JhonVelasquez/Car_Speed_Control_2_wheels/Generation_path/pngwing.com.png

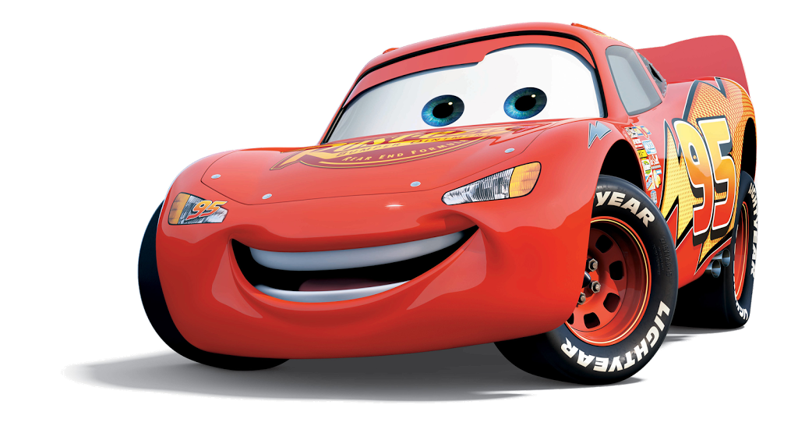
Generation_path/pngwing.com.png
