JhonVelasquez/Car_Speed_Control_2_wheels/README.md

# Car_Speed_Control_2_wheels

Project that contains code for simulating and controlling DC motors in a car.

Details in ES_report.pdf

Languagues:
- C++ (Arduino)
- Matlab script
