JhonVelasquez/Car_Speed_Control_2_wheels/FreeRTOS_ControlMotor_two_channel_improved/Command.h

#ifndef COMMAND_
#define COMMAND_
#include "DefineCustomed.h"

class Command{
  public:
    int command_id;
    int number_data;
    float *data_float_array;
    Command();
};

Command::Command(){
  command_id = 0;
  number_data = 0;
  data_float_array = new float[LENGTH_COMMAND_DATA_ARRAY_FLOAT];
}         

#endif
